Very1ucky/RPZ/RPZ_doc/tex/preamble.inc.tex

\sloppy

% Настройки стиля ГОСТ 7-32
% Для начала определяем, хотим мы или нет, чтобы рисунки и таблицы нумеровались в пределах раздела, или нам нужна сквозная нумерация.
\EqInChapter % формулы будут нумероваться в пределах раздела
\TableInChapter % таблицы будут нумероваться в пределах раздела
\PicInChapter % рисунки будут нумероваться в пределах раздела

% Добавляем гипертекстовое оглавление в PDF
\usepackage[
bookmarks=true, colorlinks=true, unicode=true,
urlcolor=black,linkcolor=black, anchorcolor=black,
citecolor=black, menucolor=black, filecolor=black,
]{hyperref}

\AfterHyperrefFix

\usepackage{microtype}% полезный пакет для микротипографии, увы под xelatex мало чего умеет, но под pdflatex хорошо улучшает читаемость

% Тире могут быть невидимы в Adobe Reader
\ifInvisibleDashes
\MakeDashesBold
\fi

\usepackage{graphicx}   % Пакет для включения рисунков

% С такими оно полями оно работает по-умолчанию:
% \RequirePackage[left=20mm,right=10mm,top=20mm,bottom=20mm,headsep=0pt,includefoot]{geometry}
% Если вас тошнит от поля в 10мм --- увеличивайте до 20-ти, ну и про переплёт не забывайте:
\geometry{right=20mm}
\geometry{left=30mm}
\geometry{bottom=20mm}
\geometry{ignorefoot}% считать от нижней границы текста

% Пакет Tikz
\usepackage{tikz}
\usetikzlibrary{arrows,positioning,shadows}

% Произвольная нумерация списков.
\usepackage{enumerate}

% ячейки в несколько строчек
\usepackage{multirow}

% itemize внутри tabular
\usepackage{paralist,array}

%\setlength{\parskip}{1ex plus0.5ex minus0.5ex} % разрыв между абзацами
\setlength{\parskip}{1ex} % разрыв между абзацами
\usepackage{blindtext}

%\usepackage{pscyr}

% Центрирование подписей к плавающим окружениям
%\usepackage[justification=centering]{caption}

\usepackage{newfloat}
\DeclareFloatingEnvironment[
placement={!ht},
name=Equation
]{eqndescNoIndent}
\edef\fixEqndesc{\noexpand\setlength{\noexpand\parindent}{\the\parindent}\noexpand\setlength{\noexpand\parskip}{\the\parskip}}
\newenvironment{eqndesc}[1][!ht]{%
    \begin{eqndescNoIndent}[#1]%
\fixEqndesc%
}
{\end{eqndescNoIndent}}
