Very1ucky/RPZ/Articles/Links.docx

https://ieeexplore.ieee.org/abstract/document/9774372

https://cselectricalandelectronics.com/bldc-motor-control-methods-best-controlling-method-benefits/
