Very1ucky/RPZ/RPZ_doc/tex/50-modeling.tex

\chapter{Проектирование модели системы}
\label{cha:chap4}

\section{Математическая модель двигателя}

Трёхфазный БДПТ может быть описан следующей системой уравнений\cite{art:dtc_smo}: 
\begin{align}
\label{sys:abc}
\left\{ \begin{aligned} 
  v_{WV}=R_si_{WV}+L_s\dfrac{d}{dt}i_{WV}+e_{WV}\\
  v_{VU}=R_si_{VU}+L_s\dfrac{d}{dt}i_{VU}+e_{VU}\\
  v_{UW}=R_si_{UW}+L_s\dfrac{d}{dt}i_{UW}+e_{UW}
\end{aligned} \right.,
\end{align}где $W$, $V$, $U$ --- фазы двигателя; $v_{WV}$, $v_{VU}$, $v_{UW}$ --- напряжения между соответствующими фазами; $i_{WV}$, $i_{VU}$, $i_{UV}$ --- разница токов соответствующих фаз; $e_{WV}$, $e_{VU}$, $e_{UV}$ --- противо-ЭДС между соответствующими фазами; $R_s$ --- сопротивление статора; $L_s$ --- индуктивность статора

Уравнение динамики описывается следующим образом:
\begin{align*}
	M_e = M_L+B\omega_m+J\dfrac{d\omega_m}{dt},
\end{align*}где $T_e$ --- электромагнитный момент; $M_L$ --- момент нагрузки; $B$ --- коэффициент трения; $J$ --- момент инерции ротора; $\omega_m$ --- механический момент ротора

Противо-ЭДС может быть выражена следующей зависимостью от скорости:
\begin{align*}
	e_{WVU}=k_e\omega_m,
\end{align*}где $k_e$ --- постоянная по противо-ЭДС

\section{Наблюдатель скользящего режима (SMO)}
\label{sec:smo}

Для определения положения и скорости ротора необходимо использовать наблюдатель, ведь прямому измерению эти величины недоступны. Можно рассмотреть классический наблюдатель Люенбергера \cite{art:obs_luen_bldc}, но его устойчивость сильно зависит от параметров, используемых при построении, что не подходит под требования технического задания. Поэтому был выбран наблюдатель на основе скользящего режима, т. к. он работает при вариации параметров двигателя во время работы, т. е. обладает большей робастностью. Также он требует меньше вычислительных мощностей, что критически важно в нашей системе. Далее представлено его математическое описание. 

Формула (\ref{sys:abc}) может быть представлено в двумерной $\alpha-\beta$ системе:
\begin{align}
\label{sys:albet}
\left\{ \begin{aligned} 
  &v_{\alpha}=R_si_{\alpha}+L_s\dfrac{d}{dt}i_{\alpha}+e_{\alpha}\\
  &v_{\beta}=R_si_{\beta}+L_s\dfrac{d}{dt}i_{\beta}+e_{\beta}
\end{aligned} \right.
\end{align}

Или в матричной форме: \cite{art:smo}
\begin{align}
\label{sys:albetmat}
\dot{i}_{\alpha\beta}=\Phi i_{\alpha\beta}+\Gamma v_{\alpha\beta}-\Gamma e_{\alpha\beta},
\end{align}где $i_{\alpha\beta}=\begin{bmatrix}
	i_{\alpha} & i_{\beta}
\end{bmatrix}$, $v_{\alpha\beta}=\begin{bmatrix}
	v_{\alpha} & v_{\beta}
\end{bmatrix}$, $e_{\alpha\beta}=\begin{bmatrix}
	e_{\alpha} & e_{\beta}
\end{bmatrix}$, $\Phi=\begin{bmatrix}
	-R_s/L_s & 0 \\
	0 & -R_s/L_s
\end{bmatrix}$, $\Gamma = \begin{bmatrix}
	1/L_s & 0 \\
	0 & 1/L_s
\end{bmatrix}$

Также поведение противо-ЭДС может быть выражено в следующей форме:
\begin{align}
\label{e_albet}
	\dot{e}_{\alpha\beta}=\omega_eJe_{\alpha\beta},
\end{align}где $\omega_e$ --- электрическая скорость двигателя ($\omega_e=\omega_m\cdot p$ ($p$ --- количество пар полюсов двигателя)); $J=\begin{bmatrix}
 0 & -1 \\
 1 & 0
\end{bmatrix}$

Выражения \ref{sys:albetmat} и \ref{e_albet} могут быть представлены в дискретной форме: \cite{art:smo}
\begin{align}
\label{eq:hat_i}
	&i_{\alpha\beta(k+1)}=Ai_{\alpha\beta(k)}+Bv_{\alpha\beta(k)}-Be_{\alpha\beta(k)}\\
	\label{eq:hat_e}
	&e_{\alpha\beta(k+1)}=e_{\alpha\beta(k)}+T_s\omega_{e(k)}Je_{\alpha\beta(k)},
\end{align}где $T_s$ --- период дискретизации; $A=e^{\Phi T_s}$; $B=\int_0^{T_s}e^{\Phi\tau}\Gamma d\tau=\begin{bmatrix}
	b & 0 \\
	0 & b
\end{bmatrix}$ $\left(b=\dfrac{1-e^{-R_sT_s/L_s}}{R_s}\right)$

Тогда наблюдатель на основе скользящего режима задаётся следующими уравнениями:
\begin{align}
	&\hat{i}_{\alpha\beta(k+1)}=A\hat{i}_{\alpha\beta(k)}+Bv_{\alpha\beta(k)}-B\hat{e}_{\alpha\beta(k)}-\eta sign(\tilde{i}_{\alpha\beta(k)})\\
	\label{eq:hat_e}
	&\hat{e}_{\alpha\beta(k+1)}=\hat{e}_{\alpha\beta(k)}+B^{-1}g(\tilde{i}_{\alpha\beta(k)}-A\tilde{i}_{\alpha\beta(k-1)}+\eta sign(\tilde{i}_{\alpha\beta(k-1)}))\\
	&\tilde{i}_{\alpha\beta(k)}=\hat{i}_{\alpha\beta(k)}-i_{\alpha\beta(k)}\\
	&\tilde{e}_{\alpha\beta(k)}=\hat{e_{\alpha\beta(k)}}-e_{\alpha\beta(k)},
\end{align}где $\eta$ --- коэффициент усиления по противо-ЭДС; $g$ --- коэффициент усиления по току

Выбор коэффициентов осуществляется из следующих условий:
\begin{enumerate}
	\item Если $|e_{\alpha\beta(k+1)}-e_{\alpha\beta(k)}|\leq m$ и коэффициент $g\in (0, 1)$ тогда существует $k_0$ такое, что при $k\geq k_0$ выполняется:
	\begin{align*}
		\tilde{e}_{\alpha\beta(k)}<\dfrac{m}{g}
	\end{align*}
	\item Если $|e_{\alpha\beta(k+1)}-e_{\alpha\beta(k)}|\leq m$, коэффициент $g\in (0, 1)$ и $\eta>b\dfrac{m}{g}$ тогда существует $k_0$ такое, что при $k\geq k_0$ выполняется:
	\begin{align*}
		|\tilde{i}_{\alpha\beta(k)}|\leq \eta +b\dfrac{m}{g}
	\end{align*}
\end{enumerate}

Таким образом, при правильном выборе параметров наблюдателя обеспечивается ограниченность векторов невязки по противо-ЭДС и току.

Главным недостатком такого вида наблюдателя, как и любых систем на основе скользящих режимов, является чаттеринг (дребезг) при приближении к поверхности скольжения, что уменьшает точность регулирования и увеличивает частоту переключений фаз, внося дополнительные потери и понижая срок службы электрических компонентов. Для уменьшения его влияния может применяться фильтр нижних частот на выходе оценок противо-ЭДС \cite{art:smo} и/или замена функций знакового переключения на функции переключения с насыщением \cite{art:dtc_smo}.

Оценка электрического положение ротора может быть найдено из формулы (\ref{eq:hat_e}) по следующей формуле:
\begin{align}
\label{eq:theta_e}
	\hat{\theta}_{e(k)} = \arctan\left(-\dfrac{\hat{e}_{\alpha(k)}}{\hat{e}_{\beta(k)}}\right)+\pi
\end{align}

Из чего легко можно найти скорость вращения ротора, зная число пар полюсов двигателя ($p$):
\begin{align*}
	\hat{\omega}_m = \dfrac{\hat{\theta}_{e(k)}-\hat{\theta}_{e(k-1)}}{T_s}
\end{align*}

\section{Прямое управление моментом}

Для реализации этого алгоритма управления необходимо знание электромагнитного момента ($M_e$), который может быть найден следующим образом\cite{art:dtc_smo}:  
\begin{align}
	\label{Te}
	&M_e=\dfrac{3p}{4}\left(\dfrac{d\Psi_{r\alpha}}{d\theta_e}i_{\alpha}+\dfrac{d\Psi_{r\beta}}{d\theta_e}i_{\beta}\right),
\end{align}где $\Psi_{r\alpha}$, $\Psi_{r\beta}$ --- поток ротора в $\alpha-\beta$ координатах.

Производные потока ротора от электрического положения ротора могут быть представлены следующими соотношениями:
\begin{align}
	\label{psira}
	&\dfrac{d\Psi_{r\alpha}}{d\theta_e}=\dfrac{d\Psi_{r\alpha}}{dt}\dfrac{dt}{d\theta_e}=\dfrac{1}{\omega_e}\dfrac{d\Psi_{r\alpha}}{dt}=\dfrac{e_\alpha}{\omega_e}\\
	&\dfrac{d\Psi_{r\beta}}{d\theta_e}=\dfrac{d\Psi_{r\beta}}{dt}\dfrac{dt}{d\theta_e}=\dfrac{1}{\omega_e}\dfrac{d\Psi_{r\beta}}{dt}=\dfrac{e_\beta}{\omega_e}
\end{align}

С учётом \ref{psira} и \ref{Te} получается:
\begin{align*}
	M_e=\dfrac{3p}{4}\left(\dfrac{e_{\alpha}}{\omega_e}i_{\alpha}+\dfrac{e_{\beta}}{\omega_e}i_{\beta}\right)
\end{align*}

Из этого уравнения и оценки противо-ЭДС рассчитывается значение оценки электромагнитного момента:
\begin{align}
\label{eq:T_e}
	&\hat{M}_e=\dfrac{3p}{4}\left(\dfrac{\hat{e}_{\alpha}}{\omega_e}i_{\alpha}+\dfrac{\hat{e}_{\beta}}{\omega_e}i_{\beta}\right)=\dfrac{3}{4}\left(\dfrac{\hat{e}_{\alpha}}{\omega_m}i_{\alpha}+\dfrac{\hat{e}_{\beta}}{\omega_m}i_{\beta}\right)
\end{align}	
\clearpage

\section{Модель системы в Simulink}

На основе рассмотренных математических формул, была построена модель системы, приведённая на рисунке \ref{pic:mod1}.

\begin{figure}[!h]
\centering
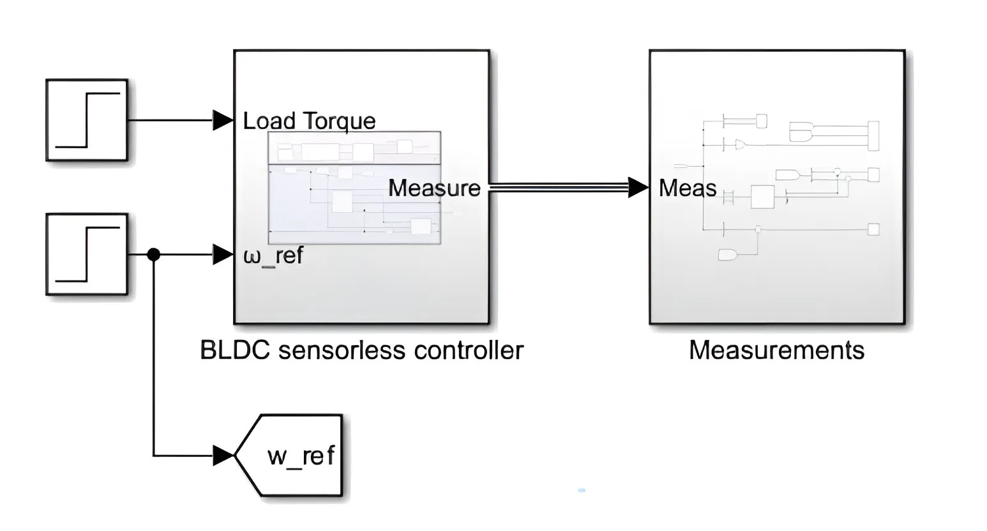
[picture p20: RPZ_doc/graphics/img/model1.png]

\caption{Общая модель системы}
\label{pic:mod1}
\end{figure}

Она состоит из двух основных блоков. Первый из них приведён на Рисунке \ref{pic:mod2} и содержит силовую часть из инвертора, двигателя и источника питания, систему управления, которая представляет из себя двухконтурный регулятор (первый контур по скорости, второй по моменту). Второй блок содержит блоки для измерения требуемых показателей системы.

Электромагнитный момент находится по формуле (\ref{eq:T_e}) на основе параметров, получаемых при оценке с помощью наблюдателя скользящего режима, описанного в \ref{sec:smo}.

\begin{figure}[!h]
\centering
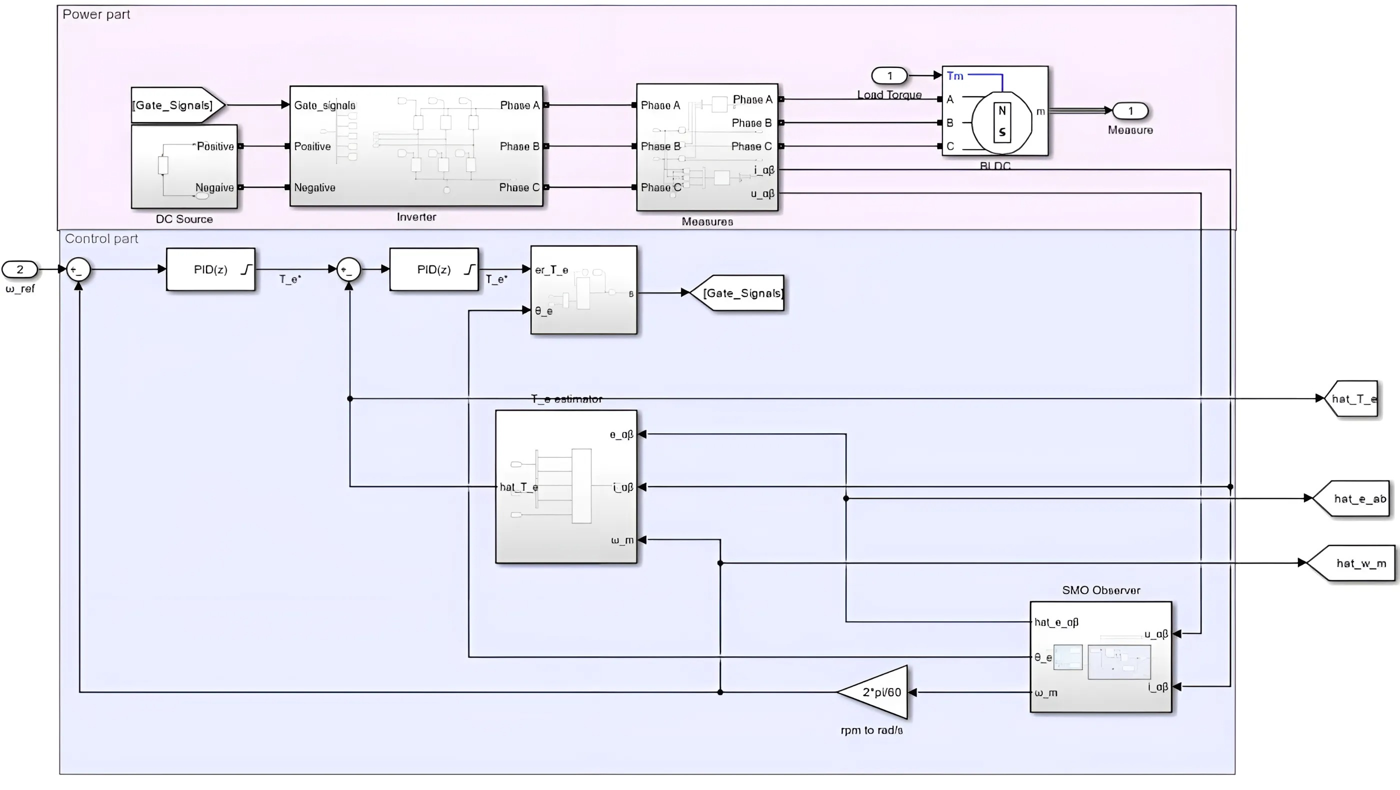
[picture p21: RPZ_doc/graphics/img/model2.png]

\caption{Блок с системой управления и силовой частью}
\label{pic:mod2}
\end{figure}

Инвертор представляет собой 6 ключей на основе Mosfet транзисторов (Рисунок \ref{pic:mod4}) и питается от источника постоянного напряжения (Рисунок \ref{pic:mod3}).

\begin{figure}[!h]
\centering
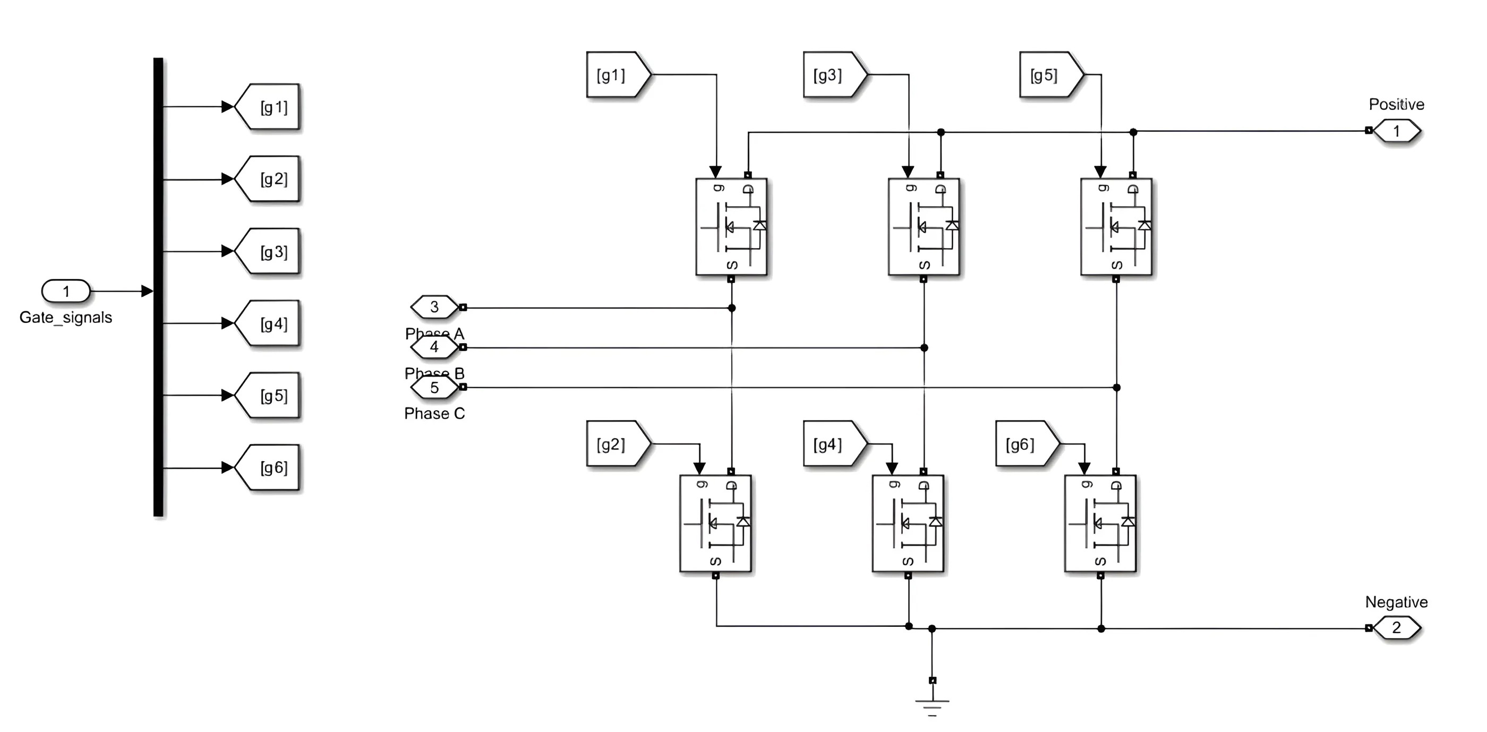
[picture p22: RPZ_doc/graphics/img/model4.png]

\caption{Трёхфазный инвертор}
\label{pic:mod4}
\end{figure}

\begin{figure}[!h]
\centering
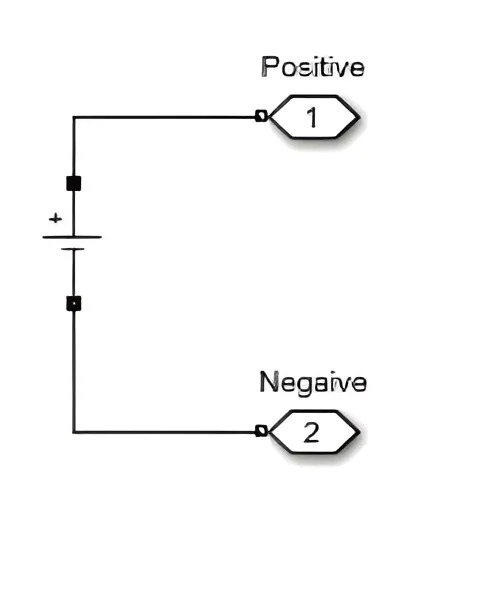
[picture p23: RPZ_doc/graphics/img/model3.png]

\caption{Источник постоянного напряжения}
\label{pic:mod3}
\end{figure}

Переключение ключей происходит по текущему электрическому положению ротора с использованием ШИМ, скважность которого регулируется в зависимости от модуля значения выхода значения, получаемого на выходе ПИ регулятора контура момента, выход которого ограничен диапазоном от $-1$ до $1$ (Рисунок \ref{pic:mod7}).

\begin{figure}[!h]
\centering
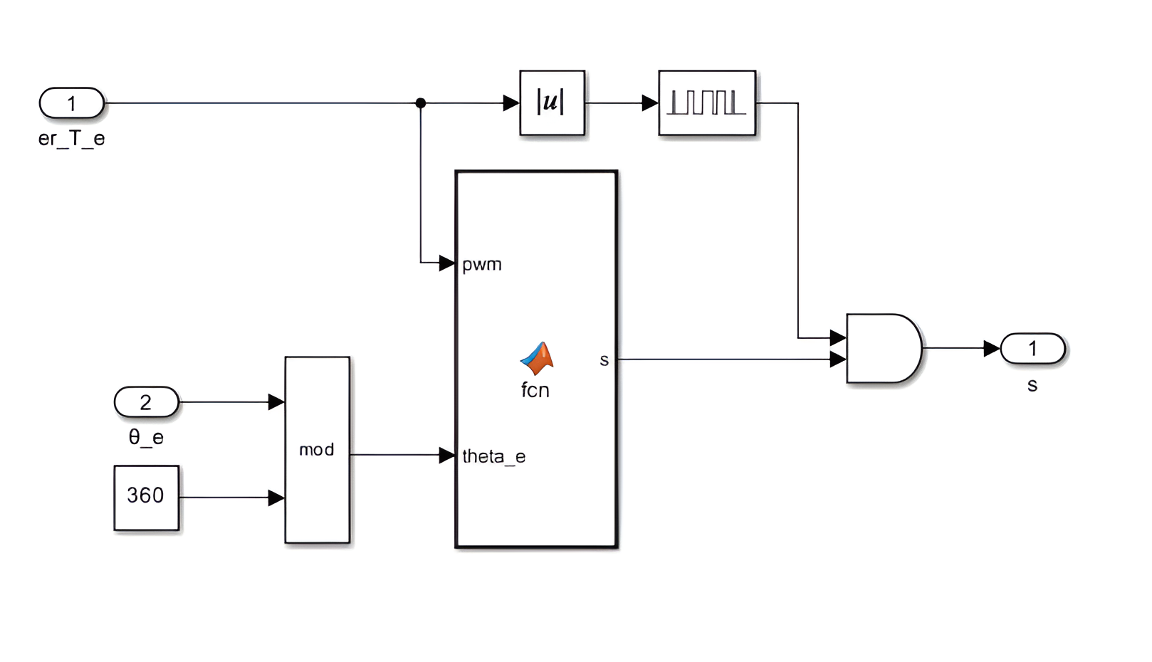
[picture p24: RPZ_doc/graphics/img/model7.png]

\caption{Система переключения ключей инвертора}
\label{pic:mod7}
\end{figure}
\clearpage

Возможные состояния в $\alpha-\beta$ системе с состояниями ключей приведены на Рисунке \ref{pic:vectors_dtc} и таблица коммутации в зависимости от электрического положения ротора и выхода ПИ регулятора момента приведены в Таблице \ref{table:com_dtc}. Общая схема модели приведена на Рисунке \ref{pic:model_scheme}.

\begin{figure}[!h]
\centering
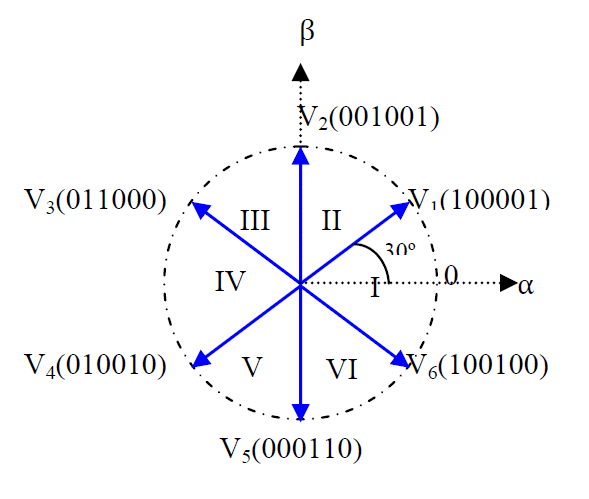
[picture p25: RPZ_doc/graphics/img/dtc_vectors.png]

\caption{Векторы переключения и состояния ключей инвертора (нумерация ключей идёт сверху вниз, справа налево (0 --- ключ закрыт, 1 --- ключ открыт)) \cite{art:dtc_smo}}
\label{pic:vectors_dtc}
\end{figure}

\begin{center}
\captionof{table}{Логика коммутации от выхода регулятора\label{table:com_dtc}}
\begin{tabular}{|c|p{1.6cm}|p{1.5cm}|p{1.5cm}|p{1.5cm}|p{1.5cm}|p{1.6cm}|}
 \hline
 Выход ПИ регулятора & \multicolumn{6}{c|}{Электрическое положения ротора, рад} \\
 \hline
 & $\frac{11\pi}{6}-\frac{\pi}{6}$ & $\frac{\pi}{6}-\frac{\pi}{2}$ & $\frac{\pi}{2}-\frac{5\pi}{6}$ & $\frac{5\pi}{6}-\frac{7\pi}{6}$ & $\frac{7\pi}{6}-\frac{3\pi}{2}$ & $\frac{3\pi}{2}-\frac{11\pi}{6}$ \\
 \hline
 [$0$-$1$] & $V_2$ & $V_3$ & $V_4$ & $V_5$ & $V_6$ & $V_1$ \\ 
 \hline
 [$-1$-$0$) & $V_5$ & $V_6$ & $V_1$ & $V_2$ & $V_3$ & $V_4$ \\
 \hline
\end{tabular}
\end{center}

\begin{figure}[!h]
\centering
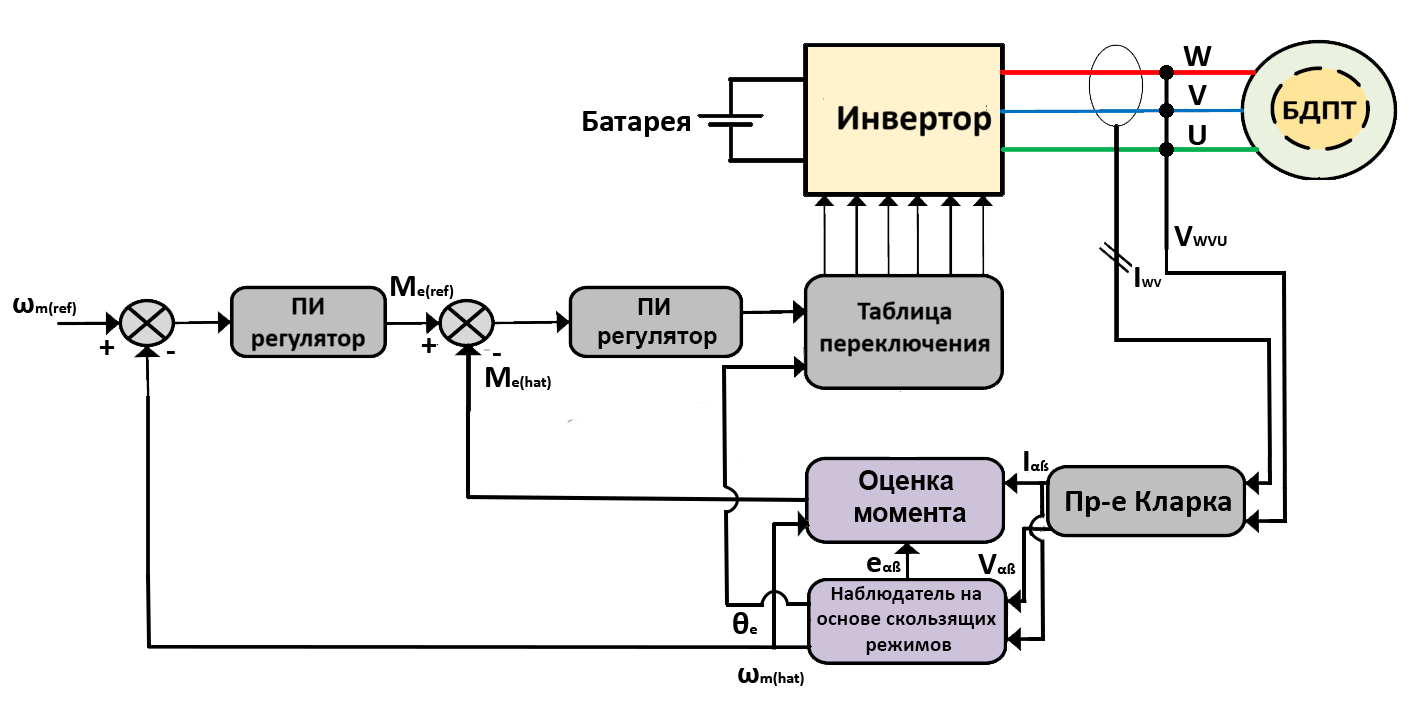
[picture p26: RPZ_doc/graphics/img/model_scheme.png]

\caption{Общая схема полученной системы управления ($I_{WV}$ --- токи фазы $W$ и $V$; $V_{WVU}$ --- вектор напряжений фаз; $\omega_{m(ref)}$, $M_{e(ref)}$ --- заданные скорость и момент регулирования; $\omega_{m(hat)}$, $\omega_{e(hat)}$ --- оценки скорости и момента; $I_{\alpha\beta}$, $V_{\alpha\beta}$, $e_{\alpha\beta}$ --- токи, напряжения и противо-ЭДС после выполнения преобразования Кларка, $\theta_e$ --- положение ротора в электрических градусах)}
\label{pic:model_scheme}
\end{figure}

\clearpage
\section{Результаты моделирования}
\label{sec:model_res}

Для моделирования использовались следующие параметры:
\begin{enumerate}
	\item параметры двигателя (значения взяты от реального двигателя (\ref{sec:choose})):
	\begin{align*}
		&R_s = 0,1\textrm{ Ом}\\
		&L_s = 0,0225\textrm{ Гн}\\
		&p = 4\\
		&k_e = 0,909\textrm{ B*мин/об}
	\end{align*}
	\item параметры наблюдателя:
	\begin{align*}
		&g = 0,9\\
		&\eta = 7,8821e-4\\
		&f_{\textrm{среза}}=1200\textrm{ Гц},
	\end{align*}где $f_{\textrm{среза}}$ --- частота среза для фильтра нижних частот на выходе оценки противо-ЭДС для уменьшения чаттеринга
	\item параметры ПИ регулятора контура скорости:
	\begin{align*}
		&K_p = 2,39\\
		&K_i = 0,05
	\end{align*}
	\item параметры ПИ регулятора контура момента:
	\begin{align*}
		&K_p = 0,01\\
		&K_i = 0,09
	\end{align*}\
	\item период дискретизации:
	\begin{align*}
		T_s = 1e-5\textrm{ с}
	\end{align*}
\end{enumerate}

Моделирования проводилось на трёх интервалах с разными заданными значениями скорости ($0-400$ рад/с, $400-600$ рад/с и $600-300$ рад/с) и каждый раз двигателю задавалось некоторая начальная скорость, ведь иначе при низких скоростях наблюдателю не получалось получить достаточно точную оценку противо-ЭДС для достижения желаемой скорости.

По техническому заданию неизвестны действительные значения сопротивления и индуктивности статора, известны лишь значения с погрешностью (в реальной работе двигателя эти параметры также могут варьироваться, например, из-за нагрева двигателя в ходе работы или других факторов), поэтому проводились моделирования также на граничных их значениях.

По результатам моделирования можно сказать, что вариация сопротивления практически не оказывает влияния на результаты работы наблюдателя и на переходные процессы в целом (Рисунки \ref{pic:R-}-\ref{pic:R+}) в сравнении с эталонными параметрами (Рисунок \ref{pic:ideal}), тогда как изменение индуктивности уменьшает скорость сходимости наблюдателя, что сказывается на времени переходного процесса и требует большего значения начальной скорости для достижения цели регулирования. Однако в пределах вариации параметров во всех экспериментах были выполнены требования, предъявляемые к алгоритму в техническом задании.

\begin{figure}[!h]
\centering

\caption{Результаты моделирования без вариации параметров (слева --- заданная, оцененная и действительная скорость ротора, справа сверху --- вектор невязки по противо-ЭДС, справа снизу --- вектор невязки по электромагнитному моменту)}
\label{pic:ideal}
\end{figure}

\begin{figure}[!h]
\centering

\caption{Результаты моделирования при уменьшении $R_s$ на $100$ \% (слева --- заданная, оцененная и действительная скорость ротора, справа сверху --- вектор невязки по противо-ЭДС, справа снизу --- вектор невязки по электромагнитному моменту)}
\label{pic:R-}
\end{figure}

\begin{figure}[!h]
\centering

\caption{Результаты моделирования при увеличении $R_s$ на $100$ \% (слева --- заданная, оцененная и действительная скорость ротора, справа сверху --- вектор невязки по противо-ЭДС, справа снизу --- вектор невязки по электромагнитному моменту)}
\label{pic:R+}
\end{figure}

\begin{figure}[!h]
\centering

\caption{Результаты моделирования при уменьшении $L_s$ на $10$ \% (слева --- заданная, оцененная и действительная скорость ротора, справа сверху --- вектор невязки по противо-ЭДС, справа снизу --- вектор невязки по электромагнитному моменту)}
\label{pic:L-}
\end{figure}

\begin{figure}[!h]
\centering

\caption{Результаты моделирования при увеличении $L_s$ на $10$ \% (слева --- заданная, оцененная и действительная скорость ротора, справа сверху --- вектор невязки по противо-ЭДС, справа снизу --- вектор невязки по электромагнитному моменту)}
\label{pic:L+}
\end{figure}
