Very1ucky/RPZ/RPZ_doc/tex/80-conclusion.tex

\Conclusion % заключение к отчёту
\thispagestyle{empty}

Был разработан алгоритм управления скоростью бесколлекторных бездатчиковых двигателей постоянного тока. 

Была составлена модель с использованием выбранного алгоритма в программном комплексе Matlab/Simulink и проведено моделирование. Моделирование проводилось при исходных параметрах двигателя, а также при вариации сопротивления и индуктивности статора для проверки робастных свойств. Во всех случаях получилось добиться желаемых показателей качества.

На основе модели был разработан экспериментальный стенд с учётом требований, предъявляемых в техническом задании, и проведено исследование его работы. В итоге, также получилось достичь желаемых показателей качества, что говорит об эффективности алгоритма в практической среде.
