Very1ucky/RPZ/RPZ_doc/tex/00-title.tex

\thispagestyle{empty}

\centerline{Министерство образования и науки РФ}
\begin{center}
САНКТ-ПЕТЕРБУРГСКИЙ НАЦИОНАЛЬНЫЙ  ИССЛЕДОВАТЕЛЬСКИЙ УНИВЕРСИТЕТ ИТМО
\end{center}

\vfill

\centerline{\LARGE{ОТЧЁТ}}
\centerline{\large{по проектно-конструкторской практике}}

\vfill

Студент Сухих Даниил  группы R34403 \hfill

Научный руководитель Власов С. М.\hfill

\vfill

\centerline{Санкт-Петербург, 2024}
\clearpage
