Very1ucky/RPZ/RPZ_doc/tex/81-biblio.tex

% % Список литературы при помощи BibTeX
% Юзать так:
%
% pdflatex rpz
% bibtex rpz
% pdflatex rpz

\bibliographystyle{ugost2008}
\bibliography{rpz}

%%% Local Variables: 
%%% mode: latex
%%% TeX-master: "rpz"
%%% End:
