Very1ucky/RPZ/RPZ_doc/tex/90-appendix1.tex

\chapter{Емкостный датчик наклона}
\label{cha:appendix1}

\begin{figure}
\centering

%\caption{Характеристики выбранного двигателя}
\end{figure}

%%% Local Variables: 
%%% mode: latex
%%% TeX-master: "rpz"
%%% End:
