Very1ucky/RPZ/RPZ_doc/tex/90-appendix2.tex

\chapter{Датчик наклона на основе ампулы}
\label{cha:appendix2}

\begin{figure}
\centering

%\caption{Технические характеристики преобразователя частоты 8000M-2SR4GH}
\end{figure}

%%% Local Variables: 
%%% mode: latex
%%% TeX-master: "rpz"
%%% End:
