Very1ucky/RPZ/RPZ_doc/tex/90-appendix3.tex

\chapter{Датчик наклона на базе акселерометра}
\label{cha:appendix3}

\begin{figure}
\centering

%\caption{Технические характеристики энкодера PRI 80H22}
\end{figure}

%%% Local Variables: 
%%% mode: latex
%%% TeX-master: "rpz"
%%% End:
