Very1ucky/RPZ/RPZ_doc/tex/90-appendix4.tex

\chapter{Датчик наклона на магнитах}
\label{cha:appendix4}

\begin{figure}
\centering

%\caption{Технические характеристики энкодера PRI 80H22}
\end{figure}

%%% Local Variables: 
%%% mode: latex
%%% TeX-master: "rpz"
%%% End:
