Very1ucky/RPZ/RPZ_doc/tex/90-appendix5.tex

\chapter{Механический датчик наклона}
\label{cha:appendix5}

\begin{figure}
\centering

%\caption{Технические характеристики энкодера PRI 80H22}
\end{figure}

%%% Local Variables: 
%%% mode: latex
%%% TeX-master: "rpz"
%%% End:
