Very1ucky/RPZ/RPZ_doc/tex/90-appendix6.tex

\chapter{Характеристики датчика LIS3DH}
\label{cha:appendix6}

\begin{figure}
\centering

%\caption{Технические характеристики энкодера PRI 80H22}
\end{figure}

%%% Local Variables: 
%%% mode: latex
%%% TeX-master: "rpz"
%%% End:
