Very1ucky/RPZ/RPZ_presentation.pdf

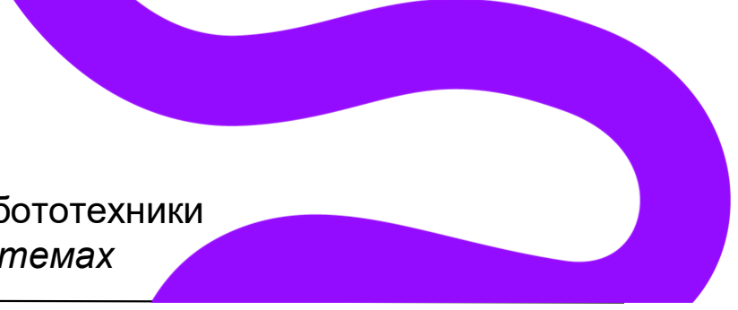
[picture p27: figure]

# Разработка системы управления бездатчиковым бесколлекторным двигателем постоянного тока

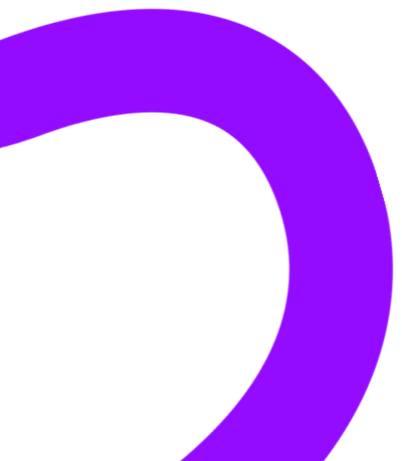
[picture p28: figure]

2024,
Санкт-Петербург

### Сухих Даниил Андреевич

Факультет Систем Управления и Робототехники Управление в технических системах

Научный руководитель:
Власов Сергей Михайлович,
доцент, кандидат технических наук

## Актуальность темы исследования

## - Преимущество БДПТ перед ДПТ с щёточно-коллекторным узлом

## - Большое количество исследований

## - Популярность

## Цель и задачи исследования

•Цель | исследования: | разработка | алгоритма | для
управления | бесколлекторными | бездатчиковыми
двигателями постоянного тока
•Задачи исследования:
а) исследование алгоритмов и обзор существующих технических решений;
б) разработка модели и синтез алгоритма управления;
в) моделирования полученной системы;
г) разработка стенда для проведения экспериментальных исследований;
д) экспериментальные исследования

## Принцип функционирования

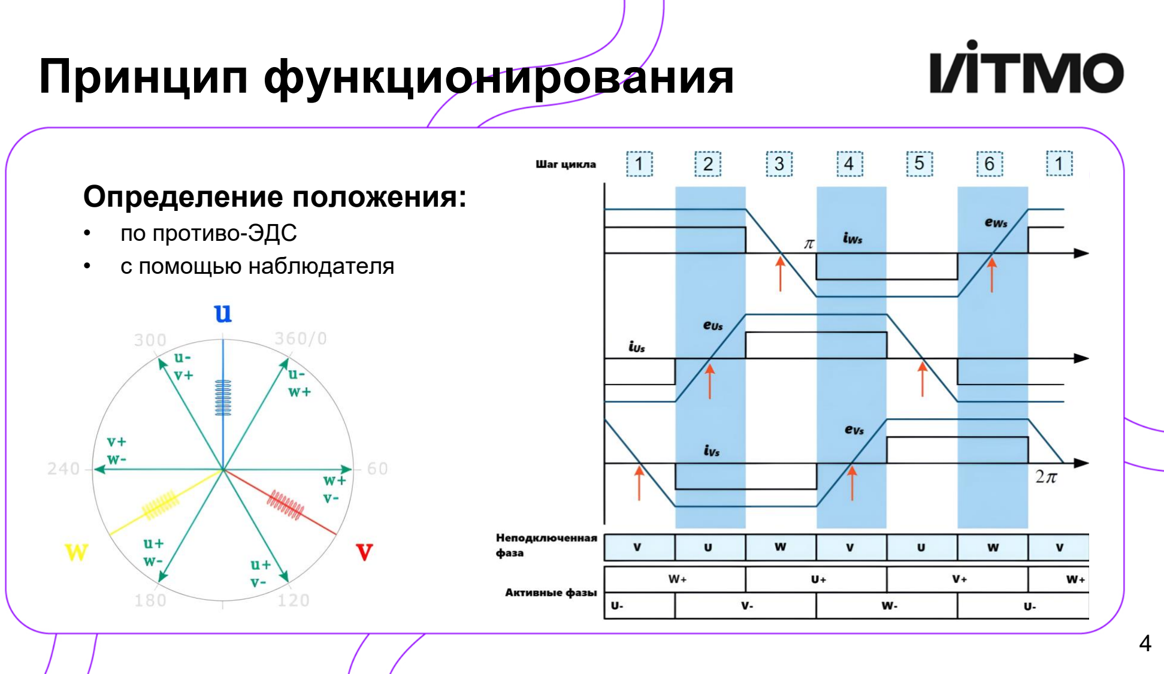
[picture p29: page 4]

Определение положения:

- по противо-ЭДС
- с помощью наблюдателя

## Алгоритмы управления скоростью

## - ПИ (ПИД) регуляторы по контуру скорости и току

## - Векторное управление

## - Прямое управление моментом

## Алгоритмы управления скоростью

## - ПИ (ПИД) регуляторы по контуру скорости и току

## - Векторное управление

## - Прямое управление моментом

## Векторное управление

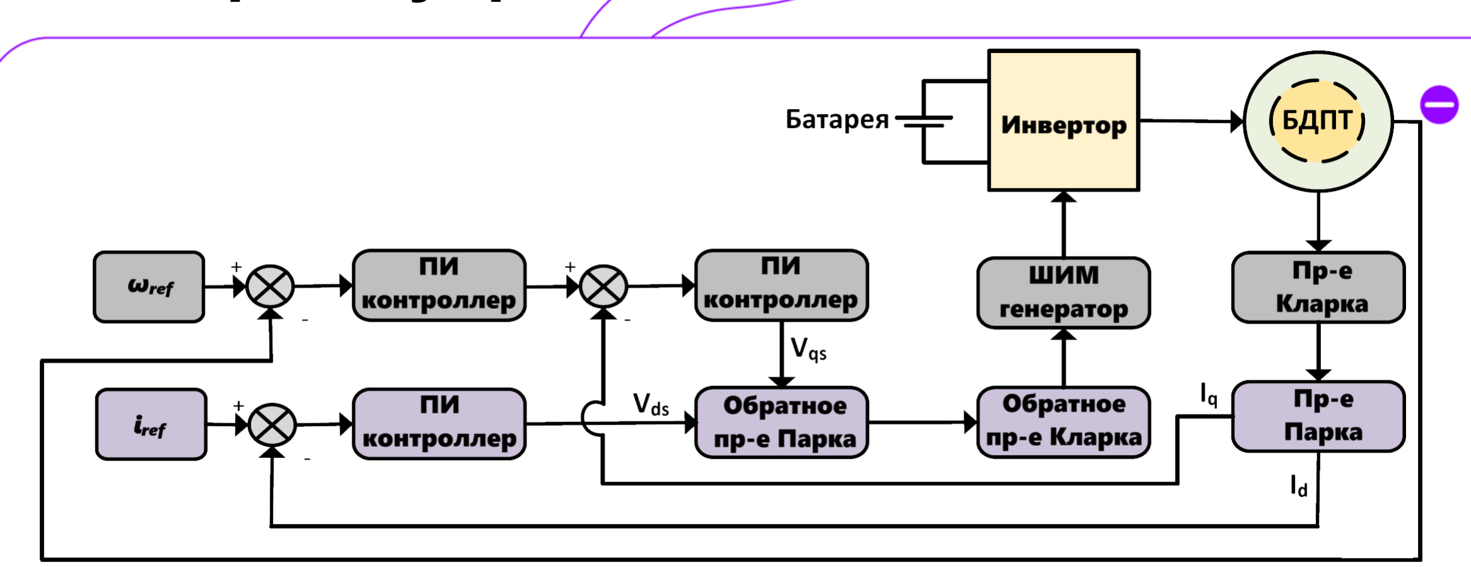
[picture p30: figure]

- ωref, iref - заданные скорость и ток
- Iq,Id - токи после выполнения пр-я Парка
- Vds, Vqs - новые векторы напряжения в d − q c-ме координат

## Прямое управление моментом

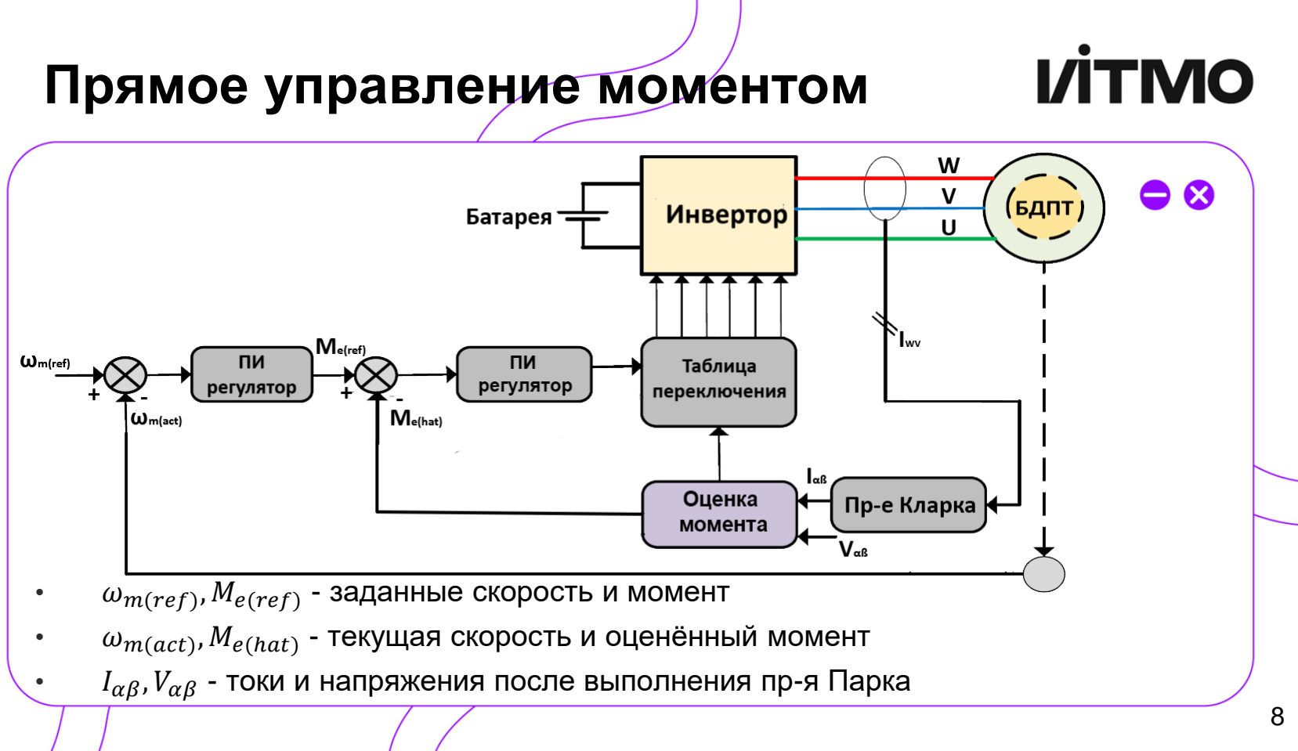
[picture p31: page 8]

- ωm(ref)

, Me(ref)
- заданные скорость и момент
- ωm(act)

, Me(ℎat)
- текущая скорость и оценённый момент
- Iαβ, Vαβ - токи и напряжения после выполнения пр-я Парка

•Робастность
•Низкие | вычислительные
затраты
•Использование только токов и напряжений фаp

Важные аспекты
алгоритма

## Разрабатываемое техническое

## решение

•Прямое управление моментом
•Наблюдатель | положения | и
скорости на основе скользящих режимов

Выбранные
решения

## Наблюдатель скользящего режима

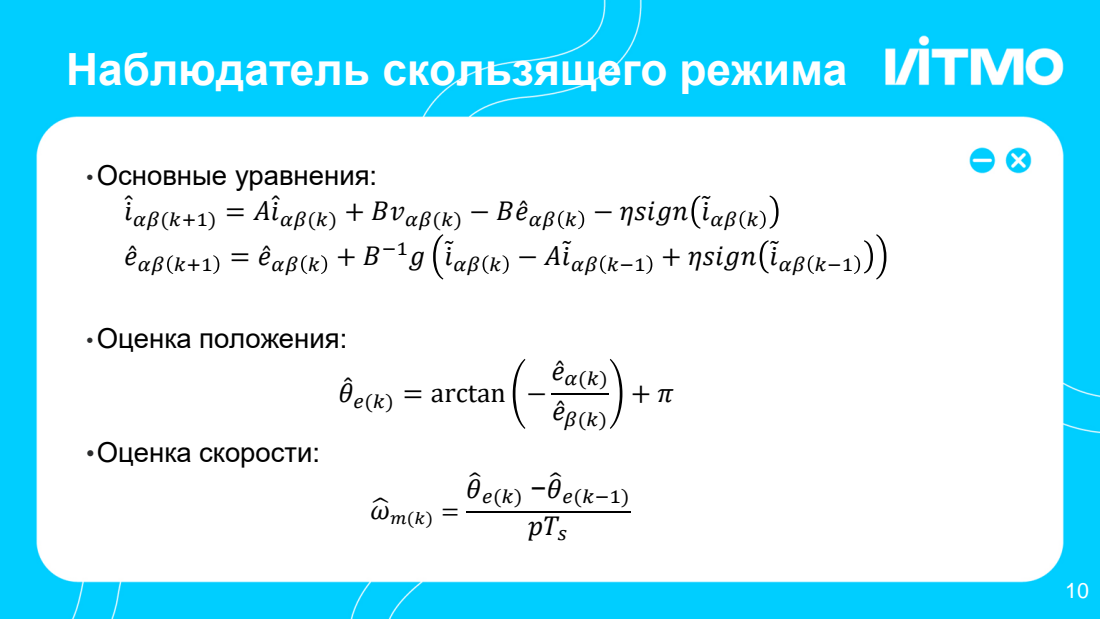
[picture p32: page 10]
eƸαβ k+1 = eƸαβ k + B; •Оценка положения:; θመ e(k) = arctan −; eƸα(k); eβƸ (k); •Оценка скорости:; e(k) −θ෠ e(k−1) pTs

•Основные уравнения:
መiሶαβ(k+1) = Aመiሶαβ(k) + Bvαβ(k) − BeƸαβ k − ηsign ሚiሶαβ k

−1g ሚiሶαβ k − Aሚiሶαβ k−1 + ηsign ሚiሶαβ k−1

## Наблюдатель скользящего режима

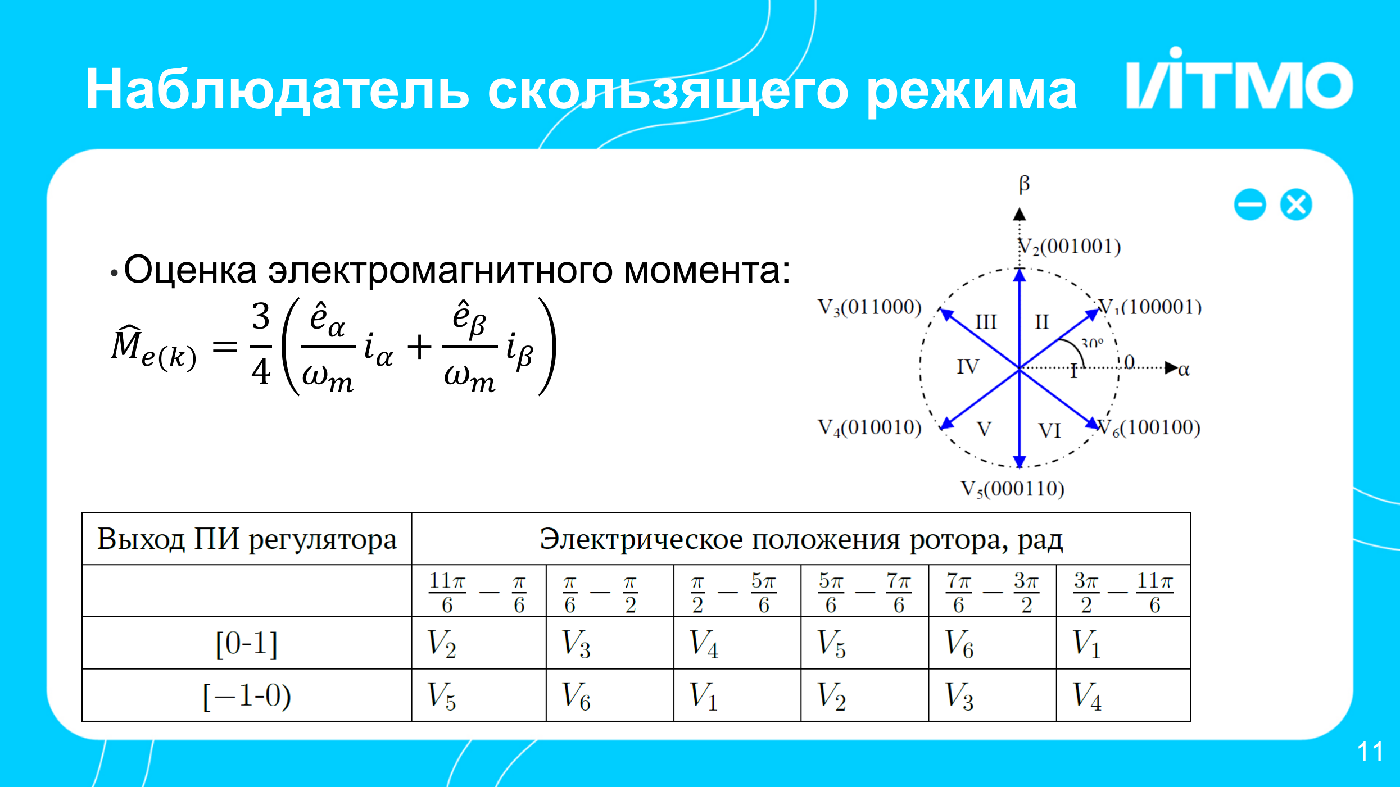
[picture p33: page 11]

•Оценка электромагнитного момента:

M෡e(k) =

3
4

eƸα
ωm

iα +

eβƸ
ωm

iβ

## Модель системы. Общая схема

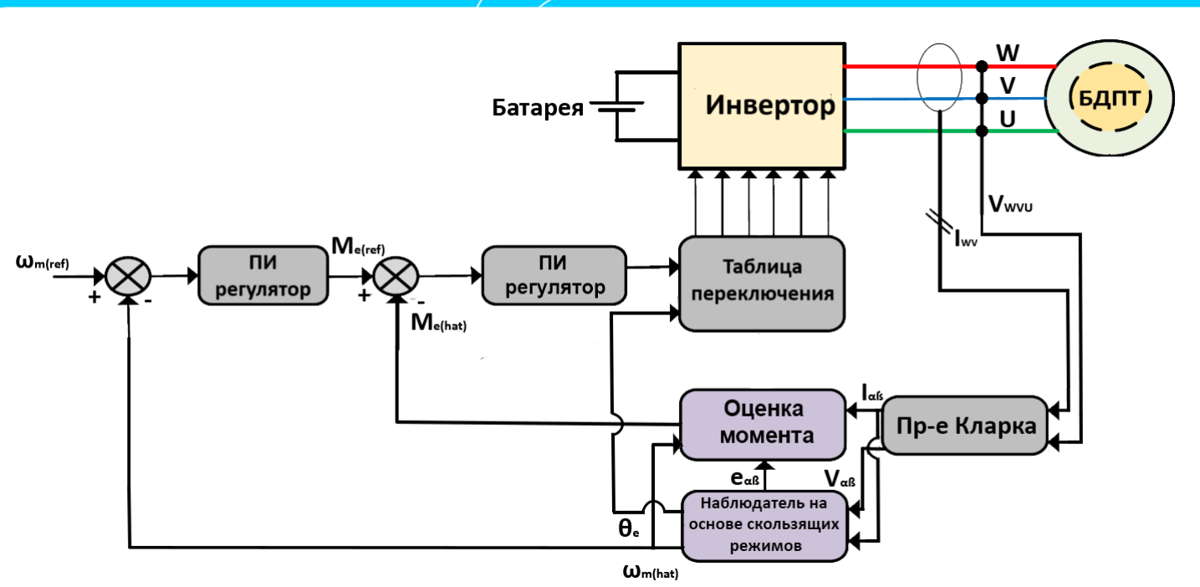
[picture p34: figure]

## Результаты моделирования

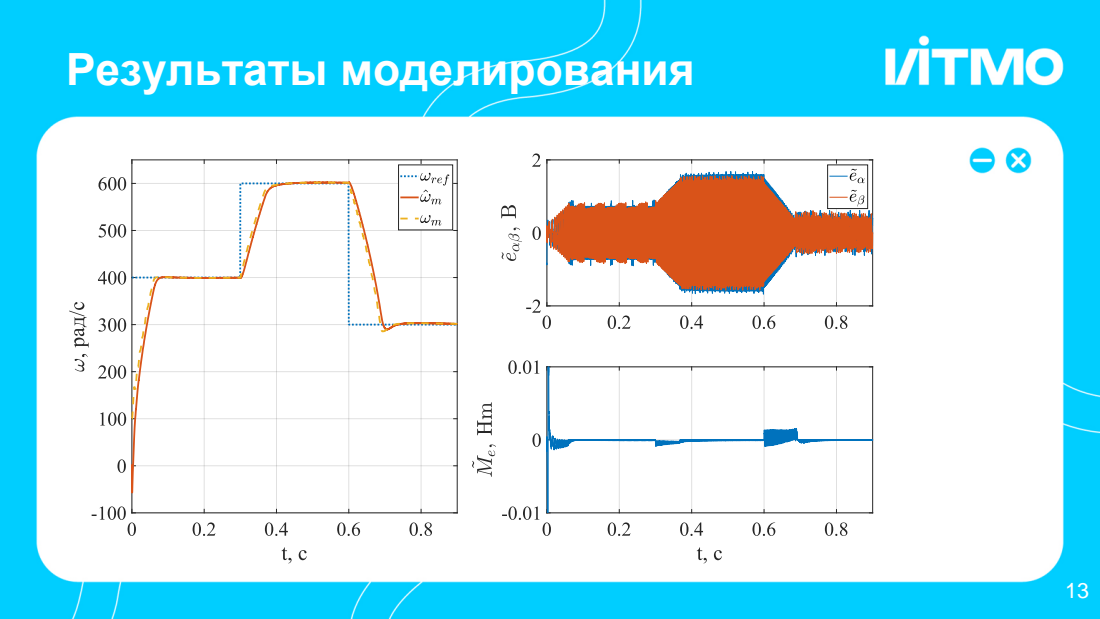
[picture p35: page 13]

## Экспериментальный стенд

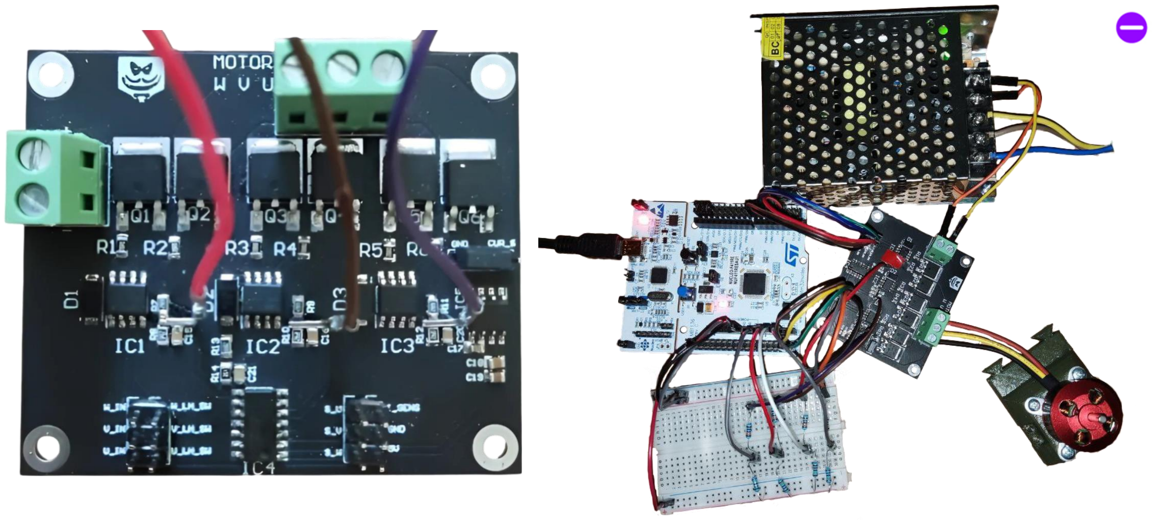
[picture p36: figure]

## Результаты эксперимента

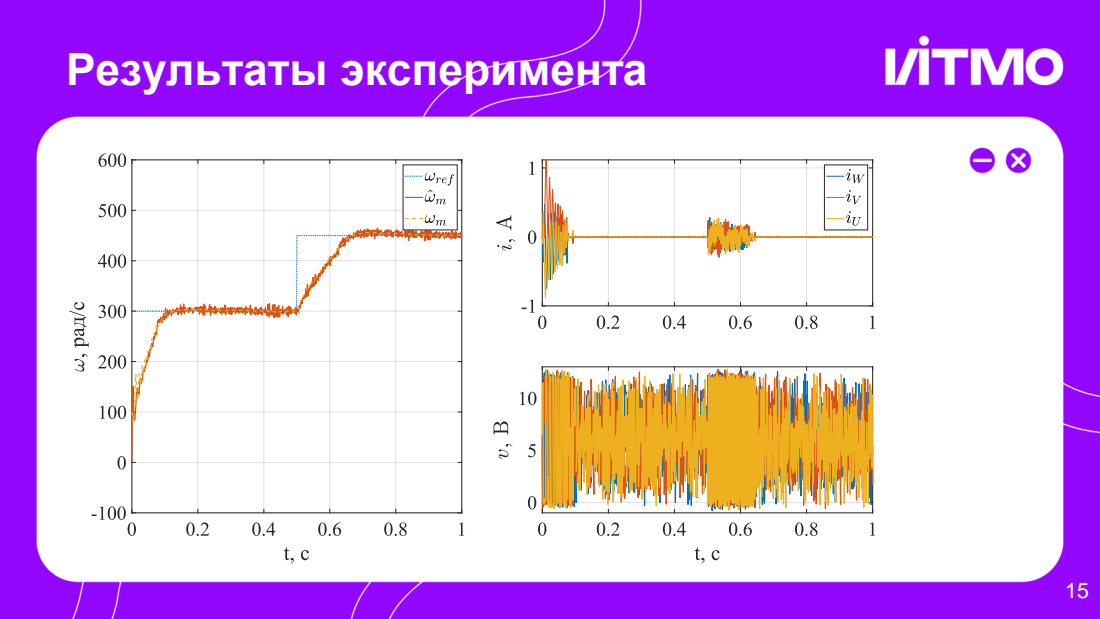
[picture p37: page 15]

## Заключение

- Был разработан алгоритм управления скоростью
бесколлекторных | бездатчиковых | двигателей
постоянного тока.
- Была | составлена | модель | и | проведено
моделирование
- Был разработан экспериментальный стенд и проведено исследование его работы

# Спасибо за внимание!

312713@niuitmo.ru
