Very1ucky/RPZ/RPZ_doc/graphics/img/log_transf.png

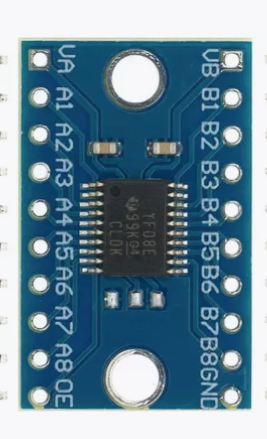
RPZ_doc/graphics/img/log_transf.png
