Very1ucky/RPZ/RPZ_doc/graphics/img/model5.png

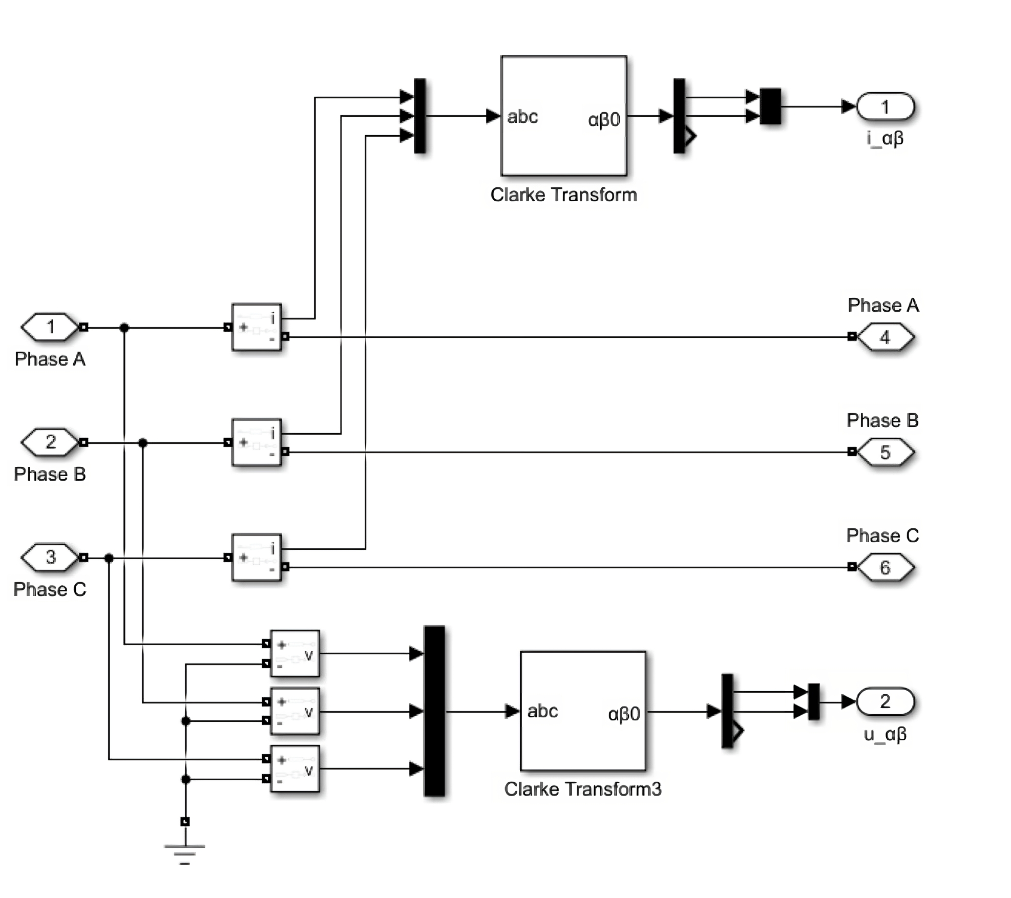
RPZ_doc/graphics/img/model5.png
