Very1ucky/RPZ/RPZ_doc/graphics/img/model6.png

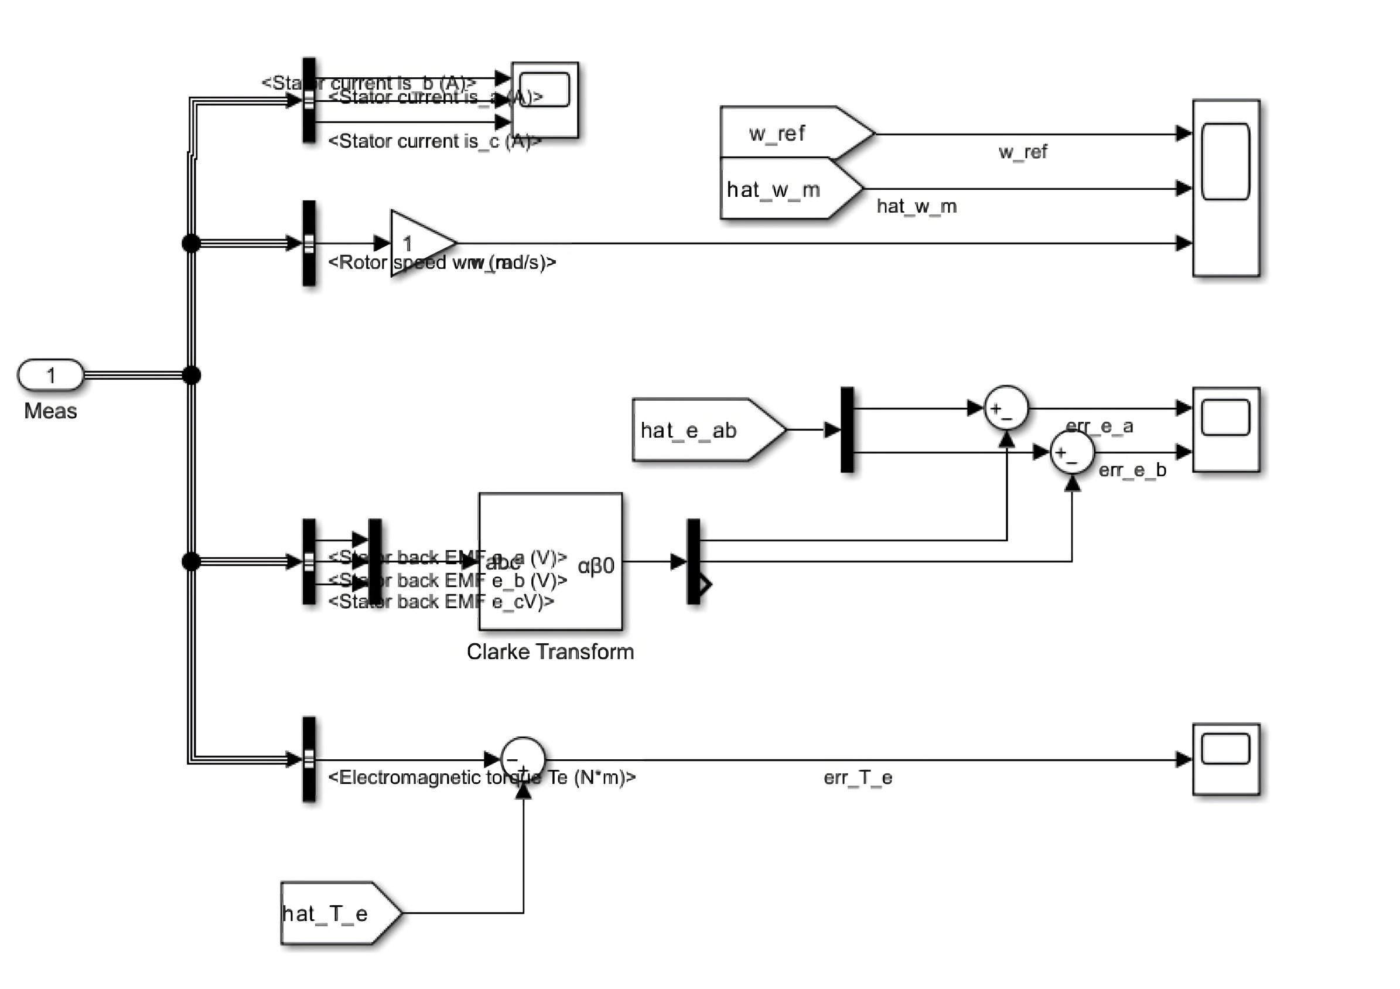
RPZ_doc/graphics/img/model6.png
