Very1ucky/RPZ/RPZ_doc/graphics/img/stand.png

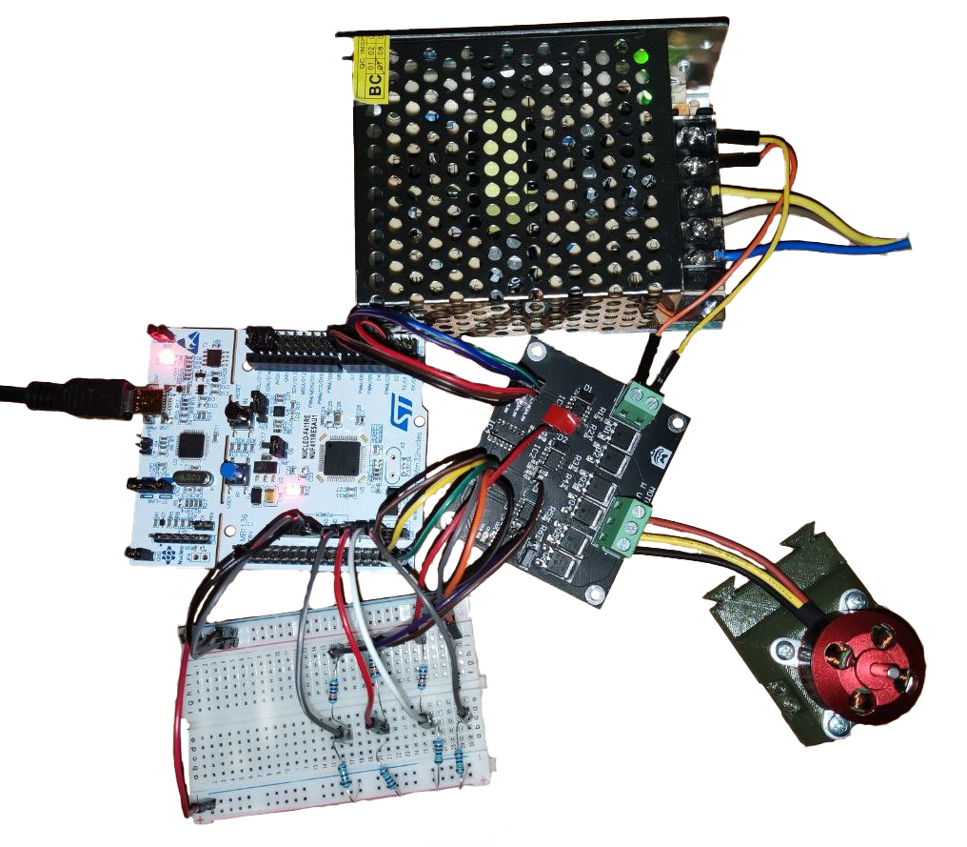
RPZ_doc/graphics/img/stand.png
