Very1ucky/RPZ/(list of files, drawings)

Other design files:
Scheme/BLDC-Another_Reference/Hardware/BLDC_driver_sensorless.PcbDoc
Scheme/BLDC-Another_Reference/Hardware/BLDC_driver_sensorless.PrjPcb
Scheme/BLDC-Another_Reference/Hardware/BLDC_driver_sensorless_logic.SchDoc
Scheme/BLDC-Another_Reference/Hardware/BLDC_driver_sensorless_power.SchDoc
Scheme/BLDC-Another_Reference/Hardware/BLDC_driver_sensorless_v2.PcbDoc
Scheme/BLDC-Another_Reference/Hardware/top.SchDoc
Scheme/BLDC-Driver/BLDC-Driver/BLDC-Driver.PcbDoc
Scheme/BLDC-Driver/BLDC-Driver/BLDC-Driver.PrjPcb
Scheme/BLDC-Driver/BLDC-Driver/control.SchDoc
Scheme/BLDC-Driver/BLDC-Driver/in_out_ports.SchDoc
Scheme/BLDC-Driver/BLDC-Driver/main.SchDoc
Scheme/BLDC-Driver/BLDC-Driver/power_part.SchDoc
Scheme/BLDC-Reference/ADC.SchDoc
Scheme/BLDC-Reference/driver.SchDoc
Scheme/BLDC-Reference/in_buf.SchDoc
Scheme/BLDC-Reference/main.PrjPCB
Scheme/BLDC-Reference/power.SchDoc
Scheme/BLDC-Reference/sensors_in.SchDoc
Scheme/BLDC-Reference/top.SchDoc
