Very1ucky/RPZ/Code/BLDC_STM32/Core/Src/main.c

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
/* Includes ------------------------------------------------------------------*/
#include "main.h"

ADC_HandleTypeDef hadc1;
DMA_HandleTypeDef hdma_adc1;

TIM_HandleTypeDef htim1;
TIM_HandleTypeDef htim3;

UART_HandleTypeDef huart2;
DMA_HandleTypeDef hdma_usart2_tx;

/* USER CODE BEGIN PV */
char str[100];
/* USER CODE END PV */

void SystemClock_Config(void);
static void MX_GPIO_Init(void);
static void MX_DMA_Init(void);
static void MX_TIM1_Init(void);
static void MX_USART2_UART_Init(void);
static void MX_ADC1_Init(void);
static void MX_TIM3_Init(void);
/* USER CODE BEGIN 0 */
#define DWT_CONTROL *(volatile unsigned long *)0xE0001000
#define SCB_DEMCR   *(volatile unsigned long *)0xE000EDFC

void DWT_Init(void)
{
    SCB_DEMCR |= CoreDebug_DEMCR_TRCENA_Msk; // разрешаем использовать счётчик
    DWT_CONTROL |= DWT_CTRL_CYCCNTENA_Msk;   // запускаем счётчик
}

/* USER CODE END 0 */

/**
  * @brief  The application entry point.
  * @retval int
  */
int main(void)
{
  /* MCU Configuration--------------------------------------------------------*/

  /* Reset of all peripherals, Initializes the Flash interface and the Systick. */
  HAL_Init();

  /* Configure the system clock */
  SystemClock_Config();

  /* Initialize all configured peripherals */
  MX_GPIO_Init();
  MX_DMA_Init();
  MX_TIM1_Init();
  MX_USART2_UART_Init();
  MX_ADC1_Init();
  MX_TIM3_Init();
  /* USER CODE BEGIN 2 */
  DWT_Init();
  RetargetInit(&huart2);
  bldc_init();
  
  HAL_TIM_PWM_Start_IT(&htim1, TIM_CHANNEL_1);
  HAL_TIM_PWM_Start_IT(&htim1, TIM_CHANNEL_2);
  HAL_TIM_PWM_Start_IT(&htim1, TIM_CHANNEL_3);

  
  // initial start of bldc on low speed
  //bldc_blind_start();
  HAL_TIM_Base_Start_IT(&htim3);
  // enable update interrupts to detect point of changing bldc commutation step
  //sprintf(str, "Count: %d, PWM: %d\r\n", __HAL_TIM_GET_COUNTER(&htim1), HAL_GPIO_ReadPin(GPIOA, GPIO_PIN_8));
  // make UEV occurs only on over
  
  //__HAL_TIM_ENABLE_IT(&htim1, TIM_IT_UPDATE);
  
  /* USER CODE END 2 */

  /* Infinite loop */
  /* USER CODE BEGIN WHILE */
  while (1)
  {
    //parse_adc_data();
    //HAL_Delay(10);
    /* USER CODE END WHILE */

    /* USER CODE BEGIN 3 */
  }
  /* USER CODE END 3 */
}

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
/* USER CODE BEGIN 4 */
uint32_t DWT_Delay_Init(void)
{
    /* Disable TRC */
    CoreDebug->DEMCR &= ~CoreDebug_DEMCR_TRCENA_Msk; // ~0x01000000;
    /* Enable TRC */
    CoreDebug->DEMCR |=  CoreDebug_DEMCR_TRCENA_Msk; // 0x01000000;
 
    /* Disable clock cycle counter */
    DWT->CTRL &= ~DWT_CTRL_CYCCNTENA_Msk; //~0x00000001;
    /* Enable  clock cycle counter */
    DWT->CTRL |=  DWT_CTRL_CYCCNTENA_Msk; //0x00000001;
 
    /* Reset the clock cycle counter value */
    DWT->CYCCNT = 0;
 
    /* 3 NO OPERATION instructions */
    __ASM volatile ("NOP");
    __ASM volatile ("NOP");
    __ASM volatile ("NOP");
 
    /* Check if clock cycle counter has started */
    if(DWT->CYCCNT)
    {
       return 0; /*clock cycle counter started*/
    }
    else
    {
      return 1; /*clock cycle counter not started*/
    }
}

void HAL_TIM_PeriodElapsedCallback(TIM_HandleTypeDef *htim) {
  if (htim->Instance == TIM3) {
    bldc_dtc_step();
    //pwm_tim_middle_period_callback();
    
    //sprintf(str, "Count: %d, PWM: %d\r\n", htim->Instance->CNT, HAL_GPIO_ReadPin(GPIOA, GPIO_PIN_8));
    //HAL_UART_Transmit_DMA(&huart2, str, strlen(str));;
  }
}

void DWT_Delay_us(volatile uint32_t au32_microseconds) {
  uint32_t au32_initial_ticks = DWT->CYCCNT;
  uint32_t au32_ticks = (HAL_RCC_GetHCLKFreq() / 1000000);
  au32_microseconds *= au32_ticks;
  while ((DWT->CYCCNT - au32_initial_ticks) < au32_microseconds - au32_ticks)
    ;
}
/* USER CODE END 4 */
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
