Very1ucky/RPZ/Code/BLDC_STM32/BLDC_STM32.ioc

Mcu.UserName=STM32F411RETx
PA0-WKUP.GPIO_Label=V_U
PA0-WKUP.Signal=ADCx_IN0
PA1.GPIO_Label=V_V
PA1.Signal=ADCx_IN1
PA10.GPIO_Label=W_PWM_CH
PA10.Signal=S_TIM1_CH3
PA13.Signal=SYS_JTMS-SWDIO
PA14.Signal=SYS_JTCK-SWCLK
PA15.Signal=SYS_JTDI
PA2.Signal=USART2_TX
PA3.Signal=USART2_RX
PA4.GPIO_Label=W_W
PA4.Signal=ADCx_IN4
PA8.GPIO_Label=U_PWM_CH
PA8.Signal=S_TIM1_CH1
PA9.GPIO_Label=V_PWM_CH
PA9.Signal=S_TIM1_CH2
PB0.GPIO_Label=I_SENS
PB0.Signal=ADCx_IN8
PB13.GPIO_Label=W_IN
PB13.Signal=GPIO_Output
PB14.GPIO_Label=V_IN
PB14.Signal=GPIO_Output
PB15.GPIO_Label=U_IN
PB15.Signal=GPIO_Output
PB3.Signal=SYS_JTDO-SWO
PC1.GPIO_Label=S_W
PC1.Signal=GPIO_Input
PC2.GPIO_Label=S_V
PC2.Signal=GPIO_Input
PC3.GPIO_Label=S_U
PC3.Signal=GPIO_Input
