Very1ucky/RPZ/Code/BLDC_STM32/Core/Inc/main.h

#define S_W_Pin GPIO_PIN_1
#define S_W_GPIO_Port GPIOC
#define S_V_Pin GPIO_PIN_2
#define S_V_GPIO_Port GPIOC
#define S_U_Pin GPIO_PIN_3
#define S_U_GPIO_Port GPIOC
#define V_U_Pin GPIO_PIN_0
#define V_U_GPIO_Port GPIOA
#define V_V_Pin GPIO_PIN_1
#define V_V_GPIO_Port GPIOA
#define W_W_Pin GPIO_PIN_4
#define W_W_GPIO_Port GPIOA
#define I_SENS_Pin GPIO_PIN_0
#define I_SENS_GPIO_Port GPIOB
#define W_IN_Pin GPIO_PIN_13
#define W_IN_GPIO_Port GPIOB
#define V_IN_Pin GPIO_PIN_14
#define V_IN_GPIO_Port GPIOB
#define U_IN_Pin GPIO_PIN_15
#define U_IN_GPIO_Port GPIOB
#define U_PWM_CH_Pin GPIO_PIN_8
#define U_PWM_CH_GPIO_Port GPIOA
#define V_PWM_CH_Pin GPIO_PIN_9
#define V_PWM_CH_GPIO_Port GPIOA
#define W_PWM_CH_Pin GPIO_PIN_10
#define W_PWM_CH_GPIO_Port GPIOA
#define W_CH TIM_CHANNEL_3
#define V_CH TIM_CHANNEL_2
#define U_CH TIM_CHANNEL_1
#define TIM_PWM_COMPARE_MIN 0
#define TIM_PWM_COMPARE_MAX 99
