Very1ucky/RPZ/Scheme/BLDC-Another_Reference/Software/sensorlessBLDC/init_ADC.c

#include "general.h"
    
/*---------------------------------------------------------------------
  Function Name: Init_ADC
  Description:   Initialize ADC module
  Inputs:        None
  Returns:       None
-----------------------------------------------------------------------*/
void Init_ADC( void )
{

	/* set port configuration here */
	ADPCFGbits.PCFG2 = 0;          // ensure AN2 is analog  - vbus 	
	ADPCFGbits.PCFG0 = 0;         // ensure AN0 is analog	- pot
 	ADPCFGbits.PCFG3 = 0;         // ensure AN3 is analog - vpha
	ADPCFGbits.PCFG4 = 0;         // ensure AN4 is analog - vphb
 	ADPCFGbits.PCFG5 = 0;         // ensure AN5 is analog - vphc
 	
  
 	/* set channel scanning here, auto sampling and convert, 
 	   with default read-format mode */
	ADCON1 = 0x00E4;
	
	/* channel scan for CH0+, Use MUX A,  
	   SMPI = 5 per interrupt, Vref = AVdd/AVss */
	ADCON2 = ADCON2_LOW_SPEED;		// intializ for low speed mode
	
	/* Set Samples and bit conversion time */
	//                                  |       |
	//                     (sample time)v       v(conversion time)
	/* Interrupt period: 5 channels * 12Tad + 12Tad  (where Tad = Tcy/2 *(ADCS<5:0> + 1))" */
	// 						5 * 24 * 1/29491200 * 1/2 * (9 + 1) = 2.0345e-5
	// Interrupt frequency: ~49 kHz
    
	ADCON3 = 0x0C09; 
    
    /* Set Samples and bit conversion time */
	//                                  |       |
	//                     (sample time)v       v(conversion time)
	/* Interrupt period: 5 channels * 12Tad + 12Tad  (where Tad = Tcy/2 *(ADCS<5:0> + 1))" */
	// 						5 * 24 * 1/14745600 * 1/2 * (4 + 1) = 2.0345e-5
	// Interrupt frequency: ~49 kHz
    
	//ADCON3 = 0x0C04; 
        	
	/* scan specified channels */
	ADCSSL = ADCSSL_LOW_SPEED;  // Scan all 5 channels
	
	/* channel select AN7 */
	ADCHS = 0x0000;

	/* reset ADC interrupt flag */
	IFS0bits.ADIF = 0;           

	/* enable ADC interrupts, disable this interrupt if the DMA is enabled */	  
	IEC0bits.ADIE = 1;       

	ADCON1bits.ADON = 1;          	
}
