Very1ucky/RPZ/(commit log)

2024-04-19 Init commit of RPZ
    [ADC.SchDoc, BLDC-Driver.PcbDoc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]
2024-05-01 Fix mc code, write received data python script
    [BLDC_STM32.ioc, app_conf.h, bldc.c, bldc.h, main.c, main.h, motor_data_worker.c, motor_data_worker.h]
